rglenn/buddy-compass/pcb/buddy-compass-control.kicad_pcb

## KiCad design pcb/buddy-compass-control.kicad_pcb (2020-02-15)

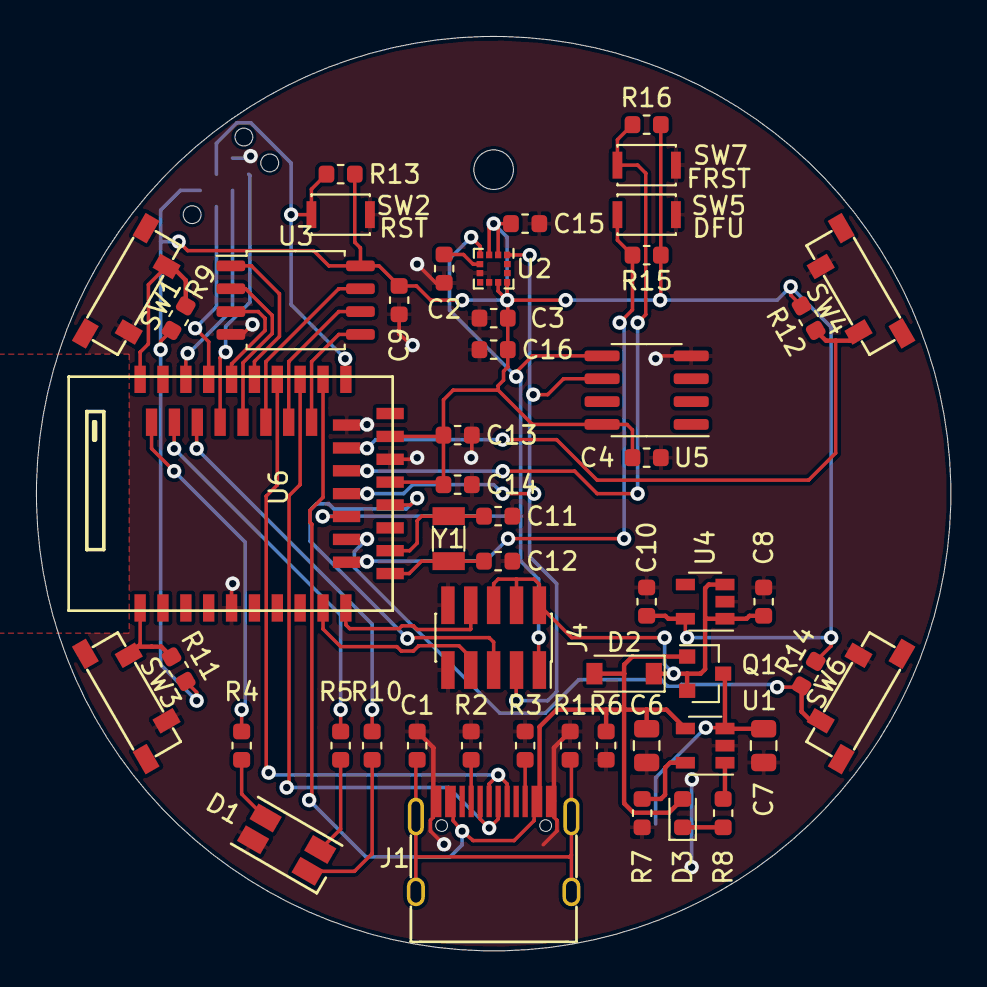
[picture p1: board buddy-compass-control.kicad_pcb from above]

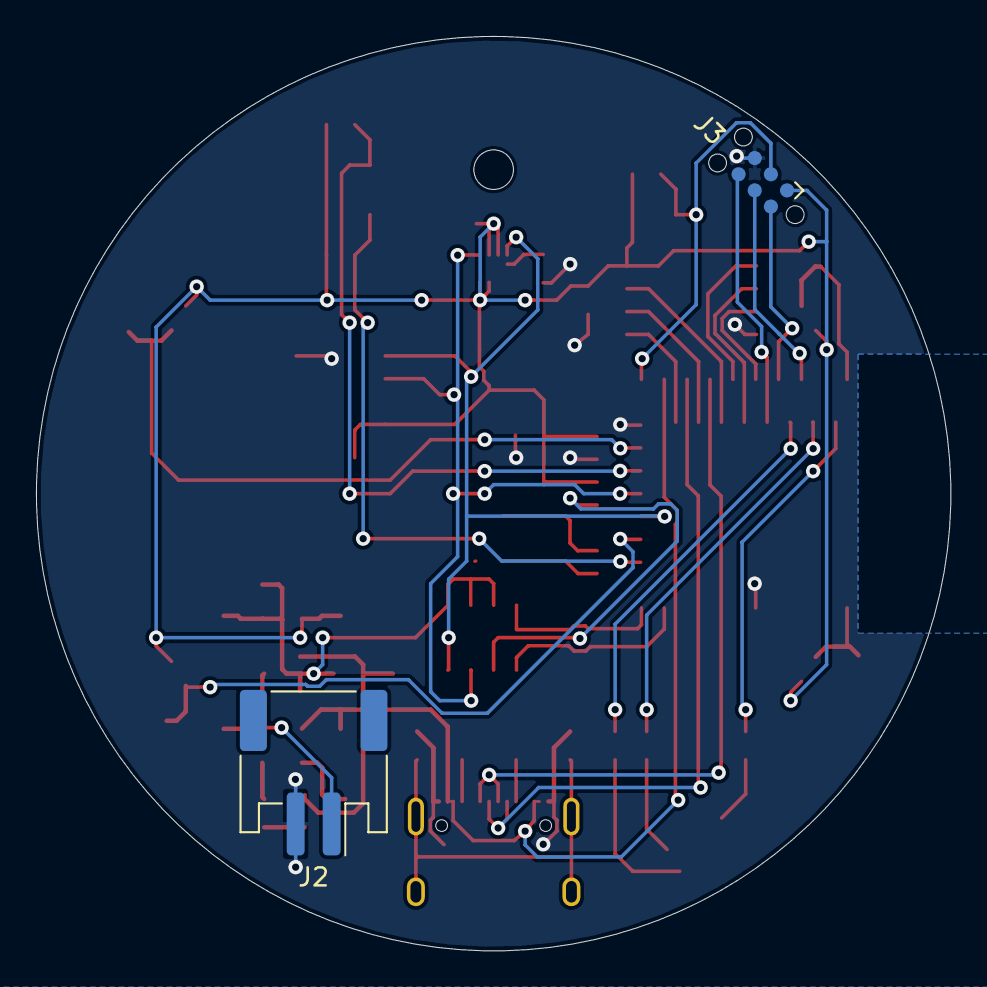
[picture p2: board buddy-compass-control.kicad_pcb from below]

Board: 2 copper layers, 50.8 x 50.8 mm, 54 parts (2 on the bottom side), 43 nets.

Parts:
C1, C3, C4, C9, C14, C15: 100n; C_0603_1608Metric
C2: 220n; C_0603_1608Metric
C6, C7: 4.7u; C_0805_2012Metric
C8, C10, C13, C16: 1u; C_0603_1608Metric
C11, C12: 12p; C_0603_1608Metric
D1: LED_RGBC; LED_RGB_1210
D2: MBR0520; D_SOD-123
D3: LED; LED_0603_1608Metric
H1: MountingHole; MountingHole_2.2mm_M2_DIN965
J1: USB_C_Receptacle_USB2.0; USB_C_Receptacle_GT-USB-7010
J2: Conn_01x02; JST_PH_S2B-PH-SM4-TB_1x02-1MP_P2.00mm_Horizontal
J3: Conn_02x03_Odd_Even; Tag-Connect_TC2030-IDC-NL_2x03_P1.27mm_Vertical
J4: Conn_02x05_Odd_Even; PinSocket_2x05_P1.27mm_Vertical_SMD
Q1: DMG2301L; SOT-23
R1: 1M; R_0603_1608Metric
R2, R3: 5.1K; R_0603_1608Metric
R4, R5, R10: 220; R_0603_1608Metric
R6: 100K; R_0603_1608Metric
R7: 2K; R_0603_1608Metric
R8: 1K; R_0603_1608Metric
R9, R11, R12, R13, R14, R15, R16: 47K; R_0603_1608Metric
SW1, SW3, SW4, SW6: SW_Push; TS-1236VW
SW2, SW5, SW7: SW_Push; SW_SPST_CK_KXT3
U1: MCP73831-2-OT; SOT-23-5
U2: LSM303C; LGA-12_2x2mm_Pitch0.5mm
U3: W25Q32JVSS; SOIC-8_5.23x5.23mm_P1.27mm
U4: MIC5504-3.3YM5; SOT-23-5
U5: ATECC608A-SSHDA; SOIC-8_3.9x4.9mm_P1.27mm
U6: E73-2G4M08S1C
Y1: 32.768KHz; Crystal_SMD_3215-2Pin_3.2x1.5mm

Connections:
+3V3: C3.1, C4.1, C9.1, C10.1, C13.1, C14.1, C15.1, C16.1, J3.1, R9.1, R11.1, R12.1, R13.1, R14.1, R15.1, R16.1, U2.2, U2.3, U2.9, U2.10, U3.8, U4.5, U5.8, U6.19, U6.23
/BUTTON1: R9.2, SW1.1, U6.43
/BUTTON3: R11.2, SW3.1, U6.1
/BUTTON4: R12.2, SW4.1, U6.22
/BUTTON6: R14.2, SW6.1, U6.14
/D+: J1.A6, J1.B6, U6.31
/D-: J1.A7, J1.B7, U6.29
/DFU: R15.2, SW5.1, U6.12
/DISPLAY_IO1: J4.7, U6.9
/DISPLAY_IO2: J4.8, U6.10
/FRST: R16.2, SW7.1, U6.20
/QSPI_CS: U3.1, U6.33
/QSPI_D0: U3.5, U6.28
/QSPI_D1: U3.2, U6.34
/QSPI_D2: U3.3, U6.35
/QSPI_D3: U3.7, U6.32
/QSPI_SCK: U3.6, U6.30
/RESET: J3.3, R13.2, SW2.1, U6.26
/SCL: J4.3, U2.1, U5.6, U6.18
/SDA: J4.1, U2.4, U5.5, U6.16
/SDB: J4.5, U6.17
/STATUS_B: R4.1, U6.42
/STATUS_G: R5.1, U6.40
/STATUS_R: R10.1, U6.38
/SWC: J3.4, U6.39
/SWD: J3.2, U6.37
/SWO: J3.6, U6.36
GND: C1.2, C2.2, C3.2, C4.2, C6.2, C7.2, C8.2, C9.2, C10.2, C11.2, C12.2, C13.2, C14.2, C15.2, C16.2, D1.4, J1.A1, J1.A12, J1.B1, J1.B12, J2.2, J3.5, J4.9, J4.10, R1.2, R2.2, R3.2, R6.2, R7.2, SW1.2, SW2.2, SW3.2, SW4.2, SW5.2, SW6.2, SW7.2, U1.2, U2.6, U2.8, U3.4, U4.2, U5.4, U6.5, U6.21, U6.24
unnamed: C1.1, J1.S1, R1.1
unnamed: C2.1, U2.5
unnamed: C7.1, J2.1, Q1.3, U1.3
unnamed: C11.1, U6.13, Y1.2
unnamed: C12.1, U6.11, Y1.1
unnamed: D1.1, R10.2
unnamed: D1.2, R5.2
unnamed: D1.3, R4.2
unnamed: D3.1, R8.1
unnamed: J1.A5, R2.1
unnamed: J1.B5, R3.1
unnamed: R7.1, U1.5
unnamed: R8.2, U1.1
VBUS: C6.1, D2.2, D3.2, J1.A4, J1.A9, J1.B4, J1.B9, Q1.1, R6.1, U1.4, U6.27
VCC: C8.1, D2.1, J4.2, J4.4, J4.6, Q1.2, U4.1, U4.3
