rglenn/buddy-compass/pcb/buddy-compass-display.kicad_pcb

## KiCad design pcb/buddy-compass-display.kicad_pcb (2020-01-28)

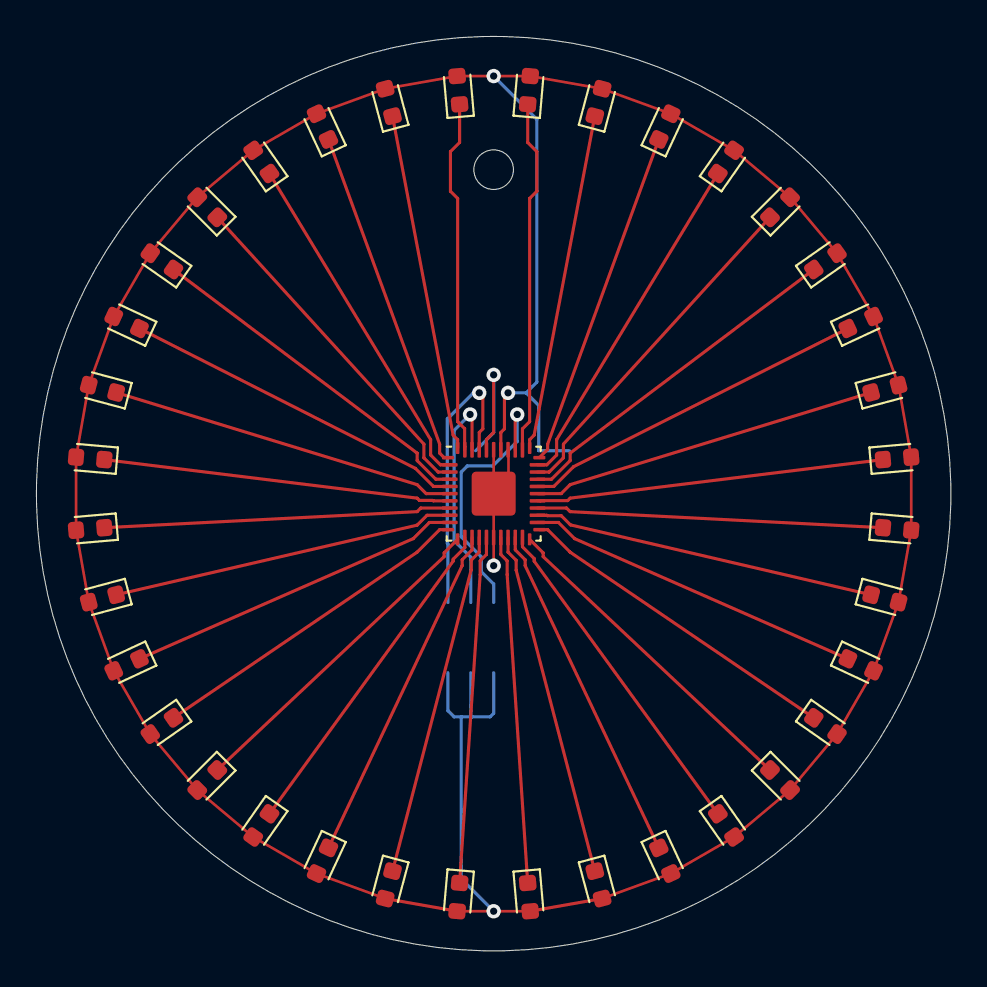
[picture p3: board buddy-compass-display.kicad_pcb from above]

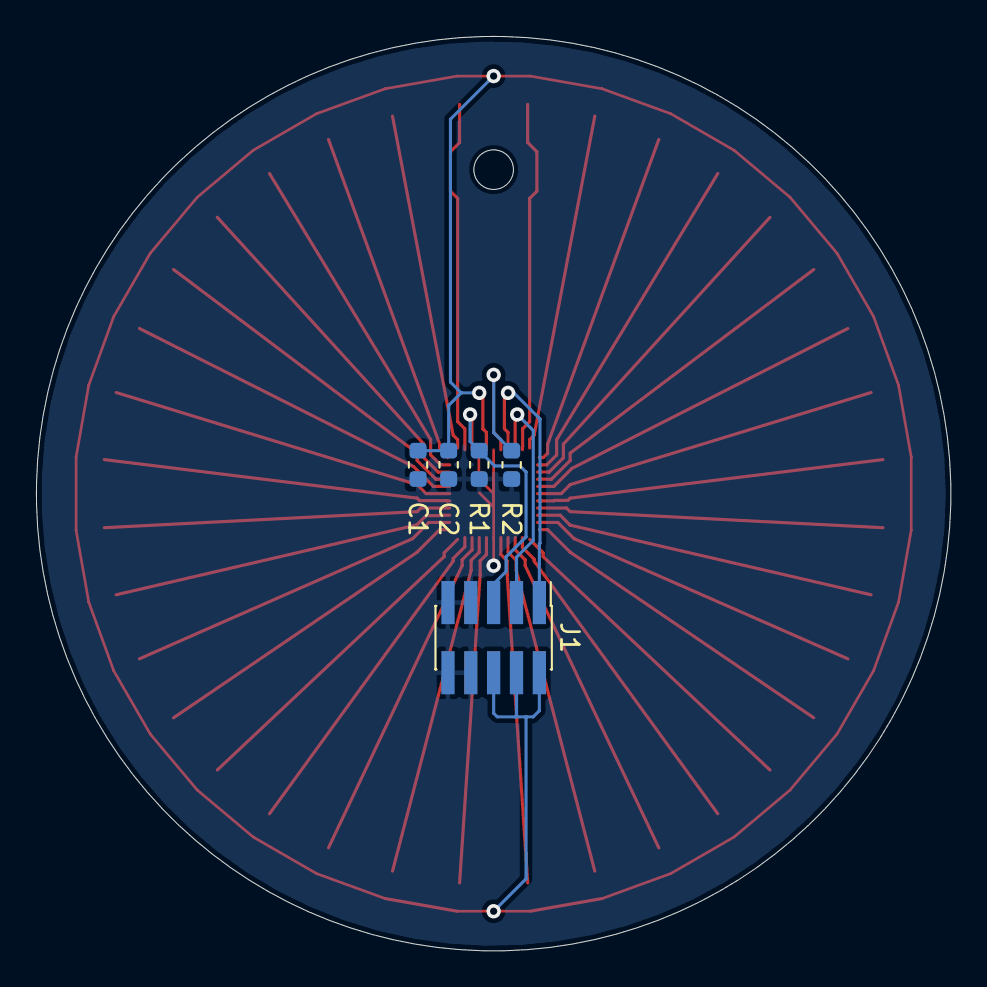
[picture p4: board buddy-compass-display.kicad_pcb from below]

Board: 2 copper layers, 50.8 x 50.8 mm, 43 parts (5 on the bottom side), 42 nets.

Parts:
C1: 1u; C_0603_1608Metric
C2: 100n; C_0603_1608Metric
D1, D2, D3, D4, D5, D6, D7, D8, D9, D10, D11, D12, D13, D14, D15, D16, D17, D18, D19, D20, D21, D22, D23, D24, D25, D26, D27, D28, D29, D30, D31, D32, D33, D34, D35, D36: LED; LED_0603_1608Metric
H1: MountingHole; MountingHole_2.2mm_M2_DIN965
J1: Conn_02x05_Odd_Even; PinHeader_2x05_P1.27mm_Vertical_SMD
R1: 100K; R_0603_1608Metric
R2: 3.3K; R_0603_1608Metric
U1: IS31FL3236A; QFN-44-1EP_5x5mm_P0.4mm_EP2.45x2.45mm

Connections:
/SCL: J1.3, U1.42
/SDA: J1.1, U1.41
/SDB: J1.5, R1.1, U1.36
GND: C1.2, C2.2, J1.7, J1.8, J1.9, J1.10, R1.2, R2.2, U1.17, U1.37, U1.39, U1.45
unnamed: D1.1, U1.35
unnamed: D2.1, U1.34
unnamed: D3.1, U1.33
unnamed: D4.1, U1.32
unnamed: D5.1, U1.31
unnamed: D6.1, U1.30
unnamed: D7.1, U1.29
unnamed: D8.1, U1.28
unnamed: D9.1, U1.27
unnamed: D10.1, U1.26
unnamed: D11.1, U1.25
unnamed: D12.1, U1.24
unnamed: D13.1, U1.23
unnamed: D14.1, U1.22
unnamed: D15.1, U1.21
unnamed: D16.1, U1.20
unnamed: D17.1, U1.19
unnamed: D18.1, U1.18
unnamed: D19.1, U1.16
unnamed: D20.1, U1.15
unnamed: D21.1, U1.14
unnamed: D22.1, U1.13
unnamed: D23.1, U1.12
unnamed: D24.1, U1.11
unnamed: D25.1, U1.10
unnamed: D26.1, U1.9
unnamed: D27.1, U1.8
unnamed: D28.1, U1.7
unnamed: D29.1, U1.6
unnamed: D30.1, U1.5
unnamed: D31.1, U1.4
unnamed: D32.1, U1.3
unnamed: D33.1, U1.2
unnamed: D34.1, U1.1
unnamed: D35.1, U1.44
unnamed: D36.1, U1.43
unnamed: R2.1, U1.40
VCC: C1.1, C2.1, D1.2, D2.2, D3.2, D4.2, D5.2, D6.2, D7.2, D8.2, D9.2, D10.2, D11.2, D12.2, D13.2, D14.2, D15.2, D16.2, D17.2, D18.2, D19.2, D20.2, D21.2, D22.2, D23.2, D24.2, D25.2, D26.2, D27.2, D28.2, D29.2, D30.2, D31.2, D32.2, D33.2, D34.2, D35.2, D36.2, J1.2, J1.4, J1.6, U1.38
