rglenn/buddy-compass/pcb/buddy-compass.kicad_pcb

## KiCad design pcb/buddy-compass.kicad_pcb (2020-01-28)

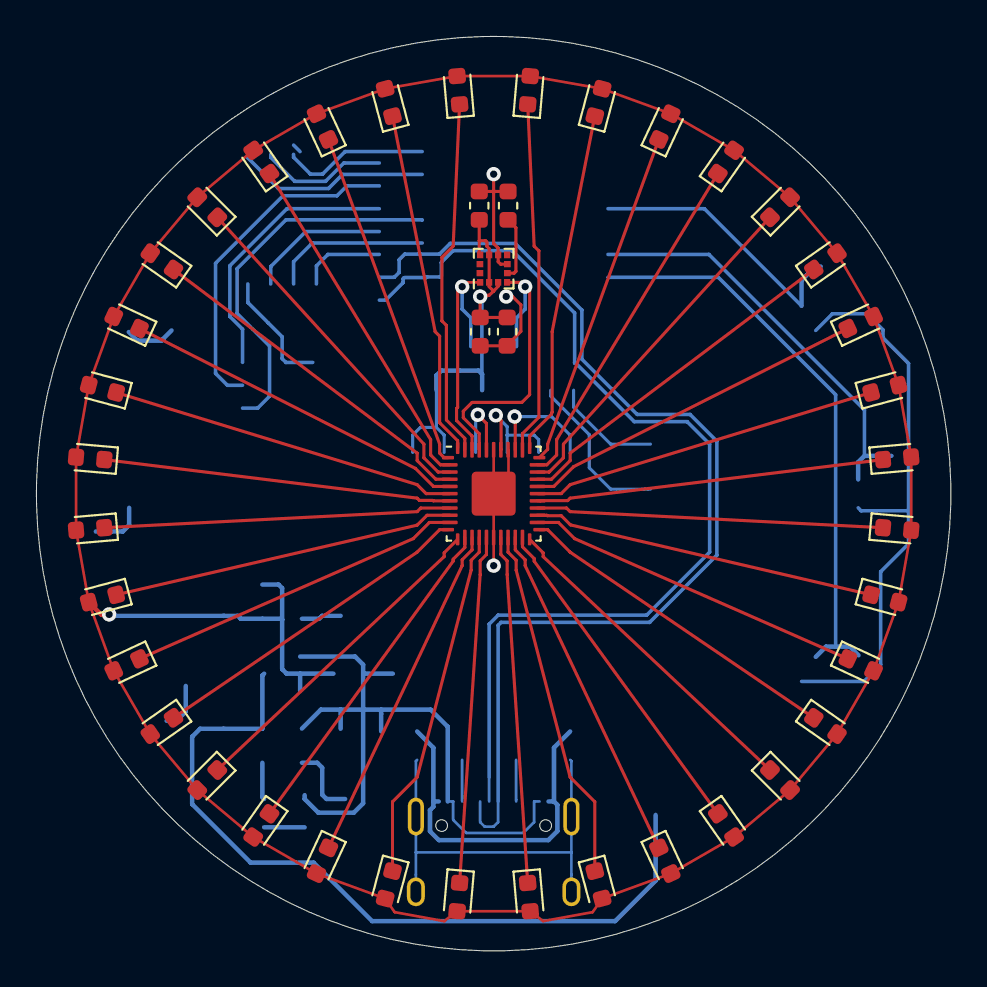
[picture p5: board buddy-compass.kicad_pcb from above]

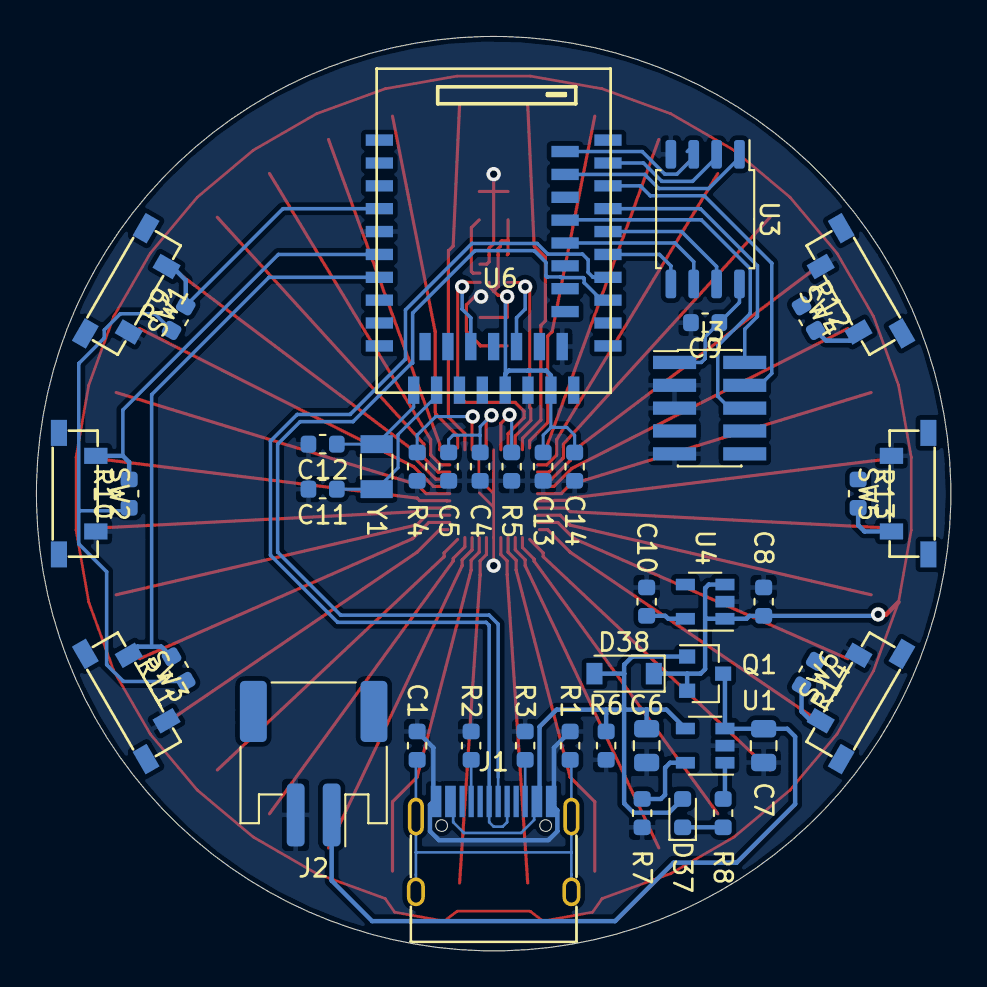
[picture p6: board buddy-compass.kicad_pcb from below]

Board: 2 copper layers, 50.8 x 50.8 mm, 85 parts (43 on the bottom side), 72 nets.

Parts:
C1, C3, C5, C9, C14, C15: 100n; C_0603_1608Metric
C2: 220n; C_0603_1608Metric
C4, C8, C10, C13, C16: 1u; C_0603_1608Metric
C6, C7: 4.7u; C_0805_2012Metric
C11, C12: 12p; C_0603_1608Metric
D1, D2, D3, D4, D5, D6, D7, D8, D9, D10, D11, D12, D13, D14, D15, D16, D17, D18, D19, D20, D21, D22, D23, D24, D25, D26, D27, D28, D29, D30, D31, D32, D33, D34, D35, D36, D37: LED; LED_0603_1608Metric
D38: MBR0520; D_SOD-123
J1: USB_C_Receptacle_USB2.0; USB_C_Receptacle_GT-USB-7010
J2: Conn_01x02; JST_PH_S2B-PH-SM4-TB_1x02-1MP_P2.00mm_Horizontal
J3: Conn_ARM_JTAG_SWD_10; PinHeader_2x05_P1.27mm_Vertical_SMD
Q1: DMG2301L; SOT-23
R1: 1M; R_0603_1608Metric
R2, R3: 5.1K; R_0603_1608Metric
R4, R6: 100K; R_0603_1608Metric
R5: 3.3K; R_0603_1608Metric
R7: 2K; R_0603_1608Metric
R8: 1K; R_0603_1608Metric
R9, R10, R11, R12, R13, R14: 47K; R_0603_1608Metric
SW1, SW2, SW3, SW4, SW5, SW6: SW_Push; TS-1236VW
U1: MCP73831-2-OT; SOT-23-5
U2: LSM303C; LGA-12_2x2mm_Pitch0.5mm
U3: W25Q32JVSS; SOIC-8_5.23x5.23mm_P1.27mm
U4: MIC5504-3.3YM5; SOT-23-5
U5: IS31FL3236A; QFN-44-1EP_5x5mm_P0.4mm_EP2.45x2.45mm
U6: E73-2G4M08S1C
Y1: 32.768KHz; Crystal_SMD_3215-2Pin_3.2x1.5mm

Connections:
+3V3: C3.1, C9.1, C10.1, C13.1, C14.1, C15.1, C16.1, J3.1, R9.1, R10.1, R11.1, R12.1, R13.1, R14.1, U2.2, U2.3, U2.9, U2.10, U3.8, U4.5, U6.19, U6.23
/BUTTON1: R9.2, SW1.1, U6.4
/BUTTON2: R10.2, SW2.1, U6.6
/BUTTON3: R11.2, SW3.1, U6.7
/BUTTON4: R12.2, SW4.1, U6.43
/BUTTON5: R13.2, SW5.1, U6.28
/BUTTON6: R14.2, SW6.1, U6.22
/D+: J1.A6, J1.B6, U6.31
/D-: J1.A7, J1.B7, U6.29
/QSPI_CS: U3.1, U6.40
/QSPI_D0: U3.5, U6.33
/QSPI_D1: U3.2, U6.41
/QSPI_D2: U3.3, U6.42
/QSPI_D3: U3.7, U6.35
/QSPI_SCK: U3.6, U6.34
/RESET: J3.10, U6.26
/SCL: U2.1, U5.42, U6.20
/SDA: U2.4, U5.41, U6.16
/SWC: J3.4, U6.39
/SWD: J3.2, U6.37
/SWO: J3.6, U6.36
GND: C1.2, C2.2, C3.2, C4.2, C5.2, C6.2, C7.2, C8.2, C9.2, C10.2, C11.2, C12.2, C13.2, C14.2, C15.2, C16.2, J1.A1, J1.A12, J1.B1, J1.B12, J2.2, J3.3, J3.5, J3.9, R1.2, R2.2, R3.2, R4.2, R5.2, R6.2, R7.2, SW1.2, SW2.2, SW3.2, SW4.2, SW5.2, SW6.2, U1.2, U2.6, U2.8, U3.4, U4.2, U5.17, U5.37, U5.39, U5.45, U6.5, U6.21, U6.24
unnamed: C1.1, J1.S1, R1.1
unnamed: C2.1, U2.5
unnamed: C7.1, J2.1, Q1.3, U1.3
unnamed: C11.1, U6.13, Y1.2
unnamed: C12.1, U6.11, Y1.1
unnamed: D1.1, U5.35
unnamed: D2.1, U5.34
unnamed: D3.1, U5.33
unnamed: D4.1, U5.32
unnamed: D5.1, U5.31
unnamed: D6.1, U5.30
unnamed: D7.1, U5.29
unnamed: D8.1, U5.28
unnamed: D9.1, U5.27
unnamed: D10.1, U5.26
unnamed: D11.1, U5.25
unnamed: D12.1, U5.24
unnamed: D13.1, U5.23
unnamed: D14.1, U5.22
unnamed: D15.1, U5.21
unnamed: D16.1, U5.20
unnamed: D17.1, U5.19
unnamed: D18.1, U5.18
unnamed: D19.1, U5.16
unnamed: D20.1, U5.15
unnamed: D21.1, U5.14
unnamed: D22.1, U5.13
unnamed: D23.1, U5.12
unnamed: D24.1, U5.11
unnamed: D25.1, U5.10
unnamed: D26.1, U5.9
unnamed: D27.1, U5.8
unnamed: D28.1, U5.7
unnamed: D29.1, U5.6
unnamed: D30.1, U5.5
unnamed: D31.1, U5.4
unnamed: D32.1, U5.3
unnamed: D33.1, U5.2
unnamed: D34.1, U5.1
unnamed: D35.1, U5.44
unnamed: D36.1, U5.43
unnamed: D37.1, R8.1
unnamed: J1.A5, R2.1
unnamed: J1.B5, R3.1
unnamed: R4.1, U5.36
unnamed: R5.1, U5.40
unnamed: R7.1, U1.5
unnamed: R8.2, U1.1
VBUS: C6.1, D37.2, D38.2, J1.A4, J1.A9, J1.B4, J1.B9, Q1.1, R6.1, U1.4, U6.27
VCC: C4.1, C5.1, C8.1, D1.2, D2.2, D3.2, D4.2, D5.2, D6.2, D7.2, D8.2, D9.2, D10.2, D11.2, D12.2, D13.2, D14.2, D15.2, D16.2, D17.2, D18.2, D19.2, D20.2, D21.2, D22.2, D23.2, D24.2, D25.2, D26.2, D27.2, D28.2, D29.2, D30.2, D31.2, D32.2, D33.2, D34.2, D35.2, D36.2, D38.1, Q1.2, U4.1, U4.3, U5.38
