rglenn/buddy-compass/(commit log)

2019-12-29 Adding first efforts on schematic and PCB. Still need footprint for BLE module.
    [buddy-compass.kicad_pcb, buddy-compass.sch]
2020-01-09 Updating schematic and PCB with LEDs laid out in a circle
    [buddy-compass.kicad_pcb, buddy-compass.sch]
2020-01-10 Making some progress on the top layout. Need to rework around the compass.
    [buddy-compass.kicad_pcb]
2020-01-20 Added buttons and footprint for MCU module. Layout for buttons and power supply is done. Still need to tweak sensor layout and LED driver layout to fit MCU underneath.
    [buddy-compass.kicad_pcb, buddy-compass.sch]
2020-01-28 I think I've routed myself into a corner - no way to lay this out properly on 2-layer without adding extraneous stuff to top layer, which would spoil the look.
    Moving to a 2-board solution.
    [buddy-compass.kicad_pcb, buddy-compass.sch]
2020-01-28 Added display-only board
    [buddy-compass-display.kicad_pcb, buddy-compass-display.sch]
2020-01-28 Adding control-only board. Needs work.
    [buddy-compass-control.kicad_pcb, buddy-compass-control.sch]
2020-02-09 Control board routing finished.
    [buddy-compass-control.kicad_pcb, buddy-compass-control.sch]
2020-02-09 Committing unsaved schematic changes
    [buddy-compass-control.sch]
2020-02-15 Added Atmel crypto chip. Renumbered some diodes. Added extra pins on display connector to allow display blanking and future upgrades.
    [buddy-compass-control.kicad_pcb, buddy-compass-control.sch]
